Xevel/ssslidar/README.md

# ssslidar
Small Solid State Lidar

The SSSlidar is a (W) 29 x (L) 39 x (H) 21 mm sensor. It is composed of 13 TOF distance sensors, 12 arranged in circular pattern and 1 looking perpendicular to the others.
