Xevel/ssslidar/elec/ssslidar_v1.0_blade_SIG_bottom.brd

## EAGLE design elec/ssslidar_v1.0_blade_SIG_bottom.brd (2016-09-15)

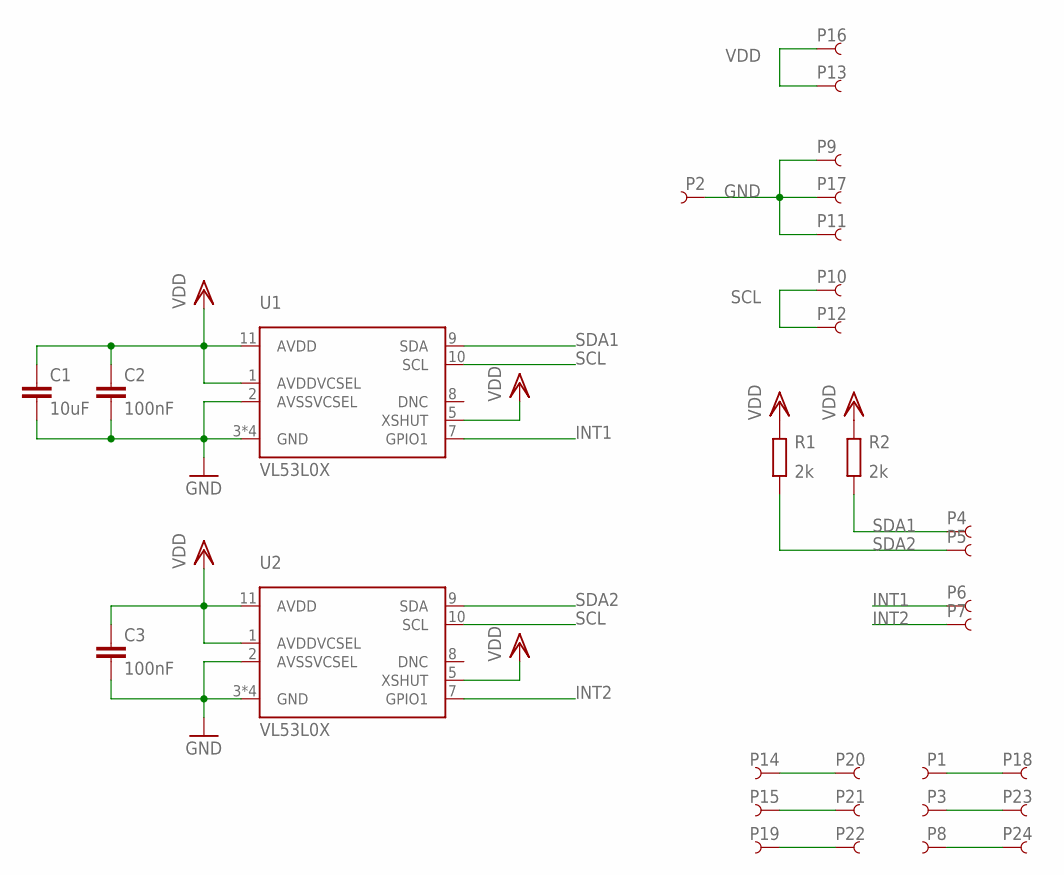
[picture p1: schematic ssslidar_v1.0_blade_SIG_bottom.sch]

Parts:
C1: 10uF; 0805_N
C2, C3: 100nF; 0402_N
P1, P3, P4, P5, P6, P7, P8, P14, P15, P18, P19, P20, P21, P22, P23, P24: PIN_SMD_0.8X1_RECT
P2, P9, P10, P11, P12, P13, P16, P17: PIN_SMD_1X2
R1, R2: 2k; 0402_N
U1, U2: VL53L0X

Connections:
GND: C1.2, C2.2, C3.2, P2.P$1, P9.P$1, P11.P$1, P17.P$1, U1.2 (AVSSVCSEL), U1.3 (GND), U1.4 (GND), U1.6 (GND), U1.12 (GND), U2.2 (AVSSVCSEL), U2.3 (GND), U2.4 (GND), U2.6 (GND), U2.12 (GND)
INT1: P6.PIN, U1.7 (GPIO1)
INT2: P7.PIN, U2.7 (GPIO1)
unnamed: P14.PIN, P20.PIN
unnamed: P15.PIN, P21.PIN
unnamed: P19.PIN, P22.PIN
unnamed: P1.PIN, P18.PIN
unnamed: P3.PIN, P23.PIN
unnamed: P8.PIN, P24.PIN
SCL: P10.P$1, P12.P$1, U1.10 (SCL), U2.10 (SCL)
SDA1: P4.PIN, R2.1, U1.9 (SDA)
SDA2: P5.PIN, R1.1, U2.9 (SDA)
VDD: C1.1, C2.1, C3.1, P13.P$1, P16.P$1, R1.2, R2.2, U1.1 (AVDDVCSEL), U1.5 (XSHUT), U1.11 (AVDD), U2.1 (AVDDVCSEL), U2.5 (XSHUT), U2.11 (AVDD)

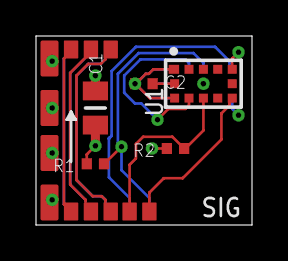
[picture p2: board ssslidar_v1.0_blade_SIG_bottom.brd from above]

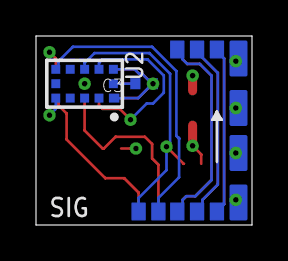
[picture p3: board ssslidar_v1.0_blade_SIG_bottom.brd from below]

Board: 4 copper layers, 12.0 x 10.5 mm, 31 parts (14 on the bottom side), 13 nets.
