Xevel/ssslidar/elec/ssslidar_v1.0_middle_plate.brd

## EAGLE design elec/ssslidar_v1.0_middle_plate.brd (2016-09-15)

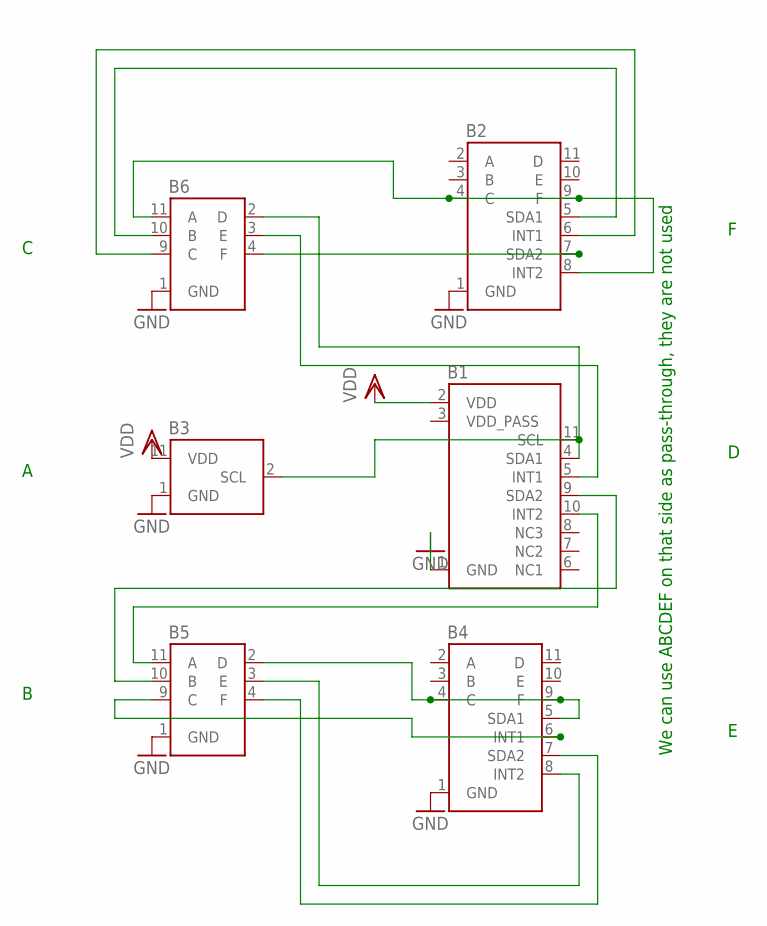
[picture p4: schematic ssslidar_v1.0_middle_plate.sch]

Parts:
B1: BLADE_PWR_BOTTOM; BLADE
B2, B4: BLADE_SIG_BOTTOM; BLADE
B3: BLADE_PWR_TOP; BLADE
B5, B6: BLADE_SIG_TOP; BLADE

Connections:
GND: B1.1 (GND), B2.1 (GND), B3.1 (GND), B4.1 (GND), B5.1 (GND), B6.1 (GND)
unnamed: B1.11 (SCL), B3.2 (SCL)
unnamed: B2.4 (C), B2.8 (INT2), B2.9 (F), B6.11 (A)
unnamed: B2.5 (SDA1), B6.10 (B)
unnamed: B2.6 (INT1), B6.9 (C)
unnamed: B1.5 (INT1), B6.3 (E)
unnamed: B2.7 (SDA2), B6.4 (F)
unnamed: B4.8 (INT2), B5.3 (E)
unnamed: B4.4 (C), B4.5 (SDA1), B4.9 (F), B5.2 (D)
unnamed: B4.6 (INT1), B5.9 (C)
unnamed: B1.9 (SDA2), B5.10 (B)
unnamed: B1.10 (INT2), B5.11 (A)
unnamed: B1.4 (SDA1), B6.2 (D)
unnamed: B4.7 (SDA2), B5.4 (F)
VDD: B1.2 (VDD), B3.11 (VDD)

Notes on the sheet:
We can use ABCDEF on that side as pass-through, they are not used

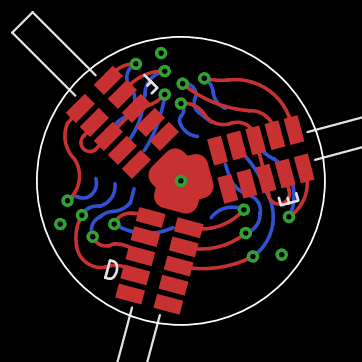
[picture p5: board ssslidar_v1.0_middle_plate.brd from above]

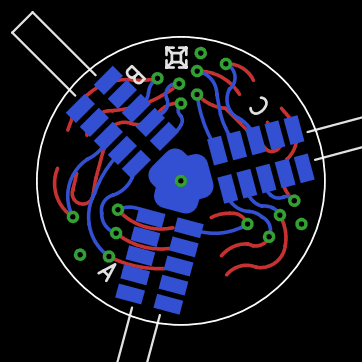
[picture p6: board ssslidar_v1.0_middle_plate.brd from below]

Board: 4 copper layers, 16.0 x 16.0 mm, 7 parts (4 on the bottom side), 15 nets.

Other parts of the board:
U$1: XEVELABS_LOGO_S
