Xevel/ssslidar/elec/ssslidar_v1.0_main_board.brd

## EAGLE design elec/ssslidar_v1.0_main_board.brd (2016-09-15)

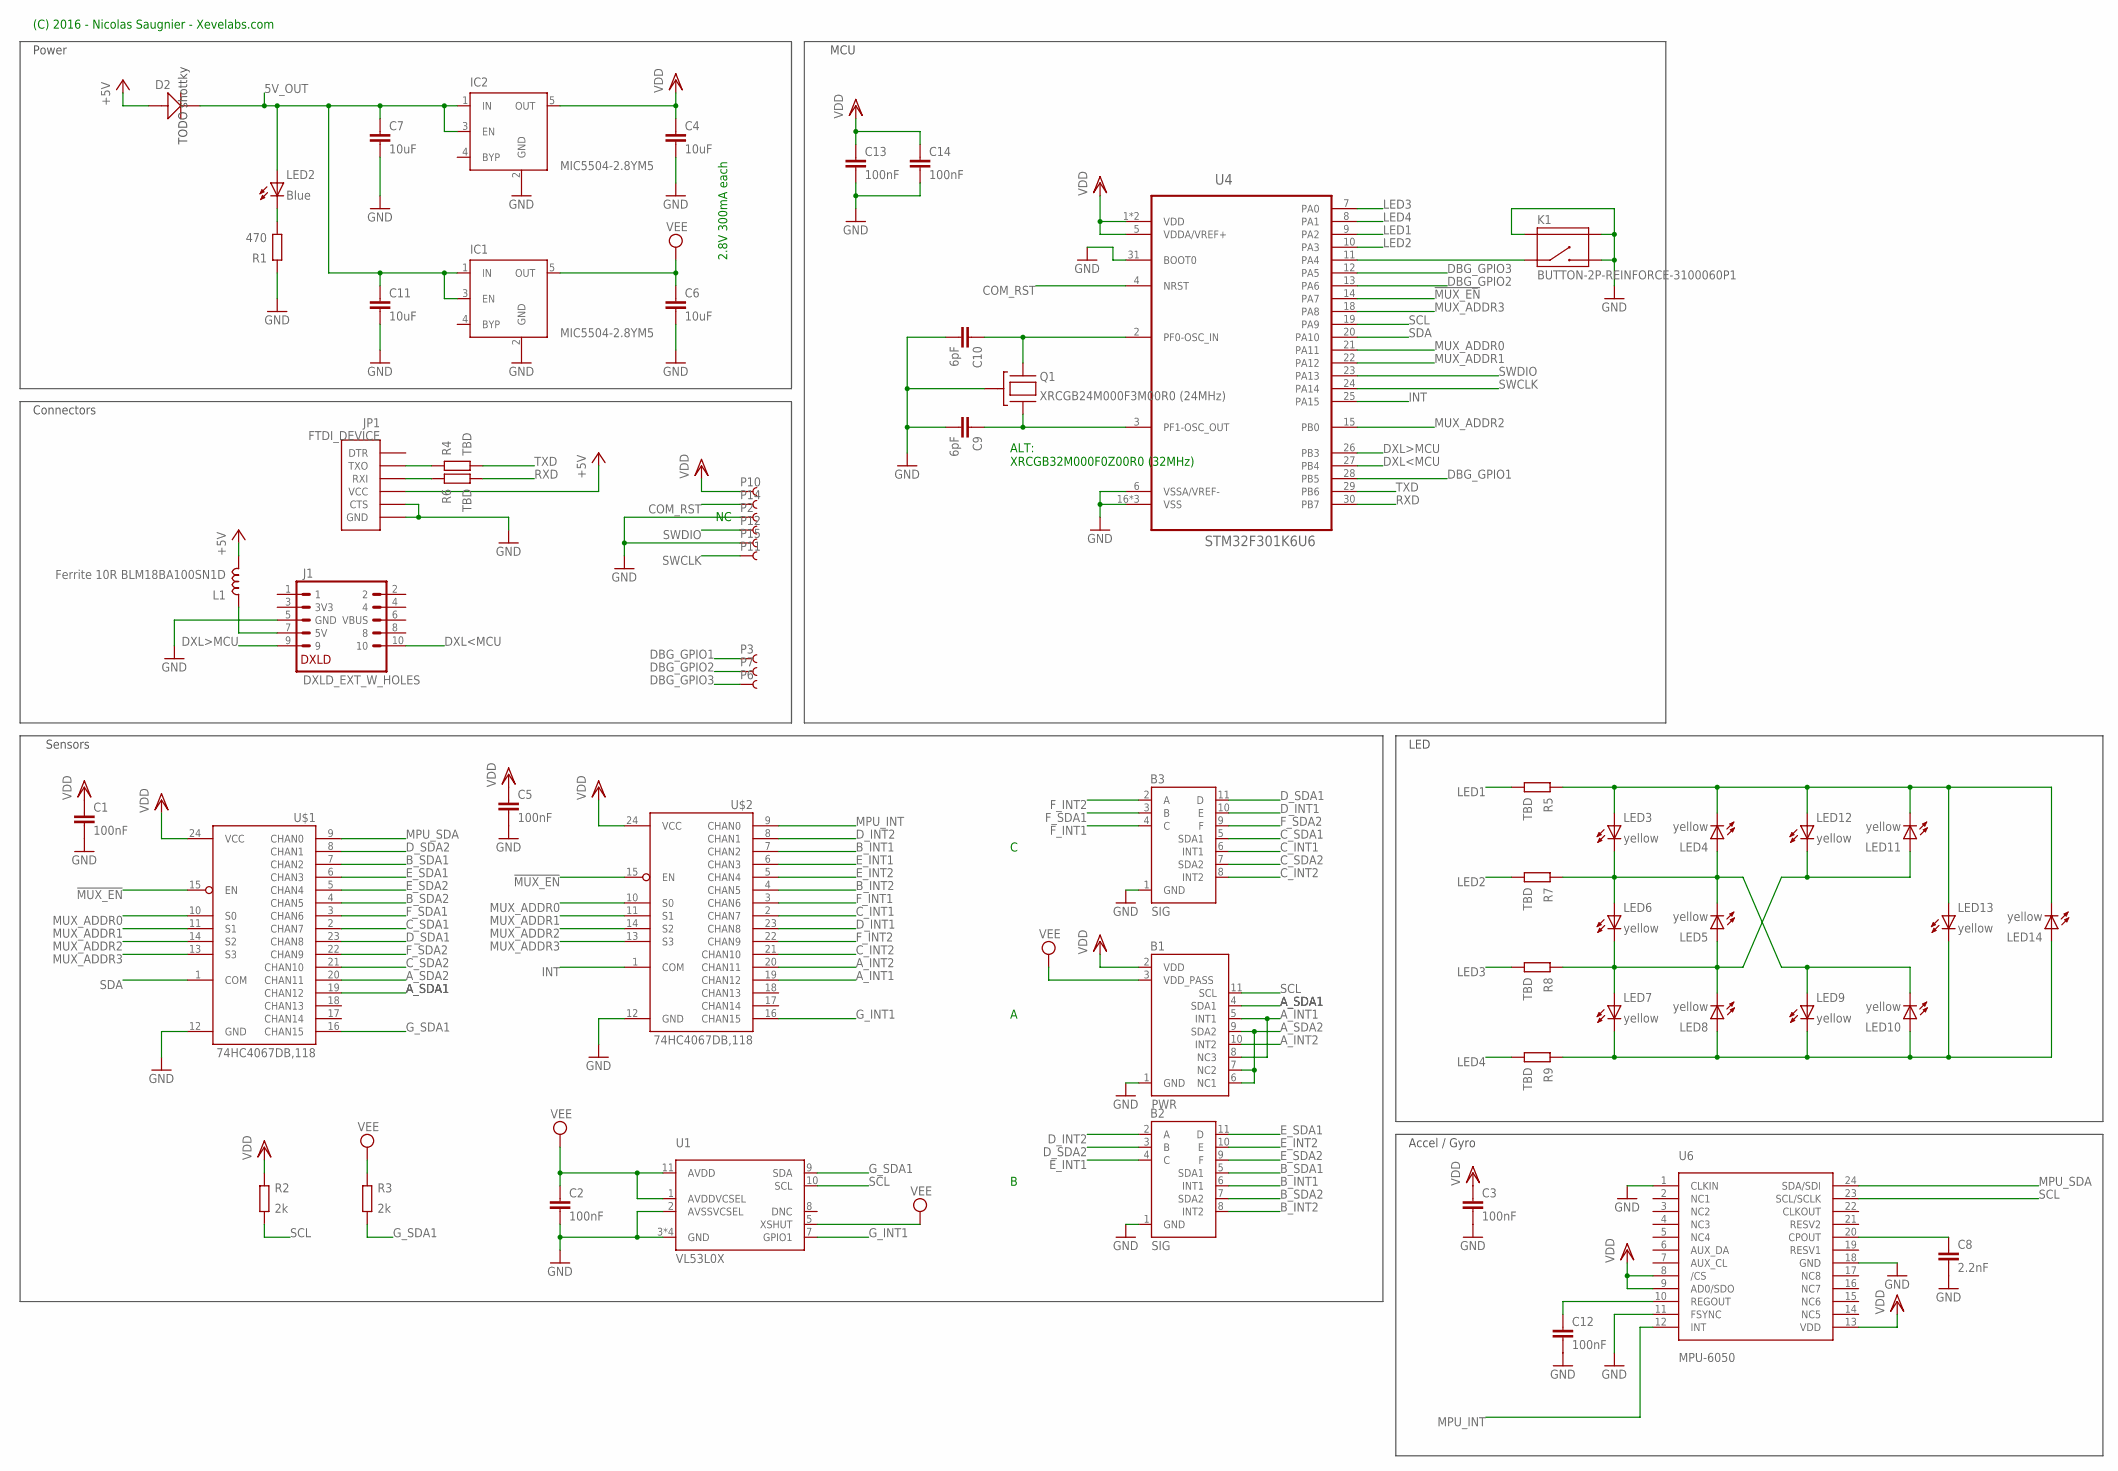
[picture p7: schematic ssslidar_v1.0_main_board.sch]

Parts:
B1: PWR; BLADE
B2, B3: SIG; BLADE
C1, C2, C3, C5, C12, C13, C14: 100nF; 0402_N
C4, C6, C7, C11: 10uF; 0805_N
C8: 2.2nF; 0402_N
C9, C10: 6pF; 0402_N
D2: D-SOD-123; SOD123
IC1, IC2: MIC5504-2.8YM5; SOT23-5
J1: DXLD_EXT_W_HOLES
JP1: FTDI_DEVICE; FTDI_DEVICE_SIDE
K1: BUTTON-2P-REINFORCE-3100060P1; 4P-SMD-7.0X3.5X3.5H-90D
L1: Ferrite 10R BLM18BA100SN1D; 0603_N
LED2: Blue; D_0603_N
LED3, LED4, LED5, LED6, LED7, LED8, LED9, LED10, LED11, LED12, LED13, LED14: yellow; D_0603_N
P2, P10, P11, P12, P14, P15: PIN_SMD_1X1.6
P3, P6, P7: PIN_SMD_1X1
Q1: XRCGB24M000F3M00R0 (24MHz); CRYSTAL_2.0X1.6_4P
R1: 470; 0402_N
R2, R3: 2k; 0402_N
R4, R5, R6, R7, R8, R9: TBD; 0402_N
U1: VL53L0X
U4: STM32F301K6U6; QFN50P500X500X60-33N
U6: MPU-6050; QFN-24
U$1, U$2: 74HC4067DB,118; SSOP24

Connections:
5V_OUT: C7.1, C11.1, D2.-, IC1.1 (IN), IC1.3 (EN), IC2.1 (IN), IC2.3 (EN), LED2.A
!MUX_EN: U4.14 (PA7), U$1.15 (EN), U$2.15 (EN)
+5V: D2.+, JP1.P$4 (VCC), L1.2
A_INT1: B1.5 (INT1), B1.8 (NC3), U$2.19 (CHAN12)
A_INT2: B1.10 (INT2), U$2.20 (CHAN11)
A_SDA1: B1.4 (SDA1), U$1.19 (CHAN12)
A_SDA2: B1.6 (NC1), B1.7 (NC2), B1.9 (SDA2), U$1.20 (CHAN11)
B_INT1: B2.6 (INT1), U$2.7 (CHAN2)
B_INT2: B2.8 (INT2), U$2.4 (CHAN5)
B_SDA1: B2.5 (SDA1), U$1.7 (CHAN2)
B_SDA2: B2.7 (SDA2), U$1.4 (CHAN5)
COM_RST: P14.PIN, U4.4 (NRST)
C_INT1: B3.6 (INT1), U$2.2 (CHAN7)
C_INT2: B3.8 (INT2), U$2.21 (CHAN10)
C_SDA1: B3.5 (SDA1), U$1.2 (CHAN7)
C_SDA2: B3.7 (SDA2), U$1.21 (CHAN10)
DBG_GPIO1: P3.P$1, U4.28 (PB5)
DBG_GPIO2: P7.P$1, U4.13 (PA6)
DBG_GPIO3: P6.P$1, U4.12 (PA5)
DXL<MCU: J1.10, U4.27 (PB4)
DXL>MCU: J1.9, U4.26 (PB3)
D_INT1: B3.10 (E), U$2.23 (CHAN8)
D_INT2: B2.2 (A), U$2.8 (CHAN1)
D_SDA1: B3.11 (D), U$1.23 (CHAN8)
D_SDA2: B2.3 (B), U$1.8 (CHAN1)
E_INT1: B2.4 (C), U$2.6 (CHAN3)
E_INT2: B2.10 (E), U$2.5 (CHAN4)
E_SDA1: B2.11 (D), U$1.6 (CHAN3)
E_SDA2: B2.9 (F), U$1.5 (CHAN4)
F_INT1: B3.4 (C), U$2.3 (CHAN6)
F_INT2: B3.2 (A), U$2.22 (CHAN9)
F_SDA1: B3.3 (B), U$1.3 (CHAN6)
F_SDA2: B3.9 (F), U$1.22 (CHAN9)
GND: B1.1 (GND), B2.1 (GND), B3.1 (GND), C1.2, C2.2, C3.2, C4.2, C5.2, C6.2, C7.2, C8.2, C9.2, C10.2, C11.2, C12.2, C13.2, C14.2, IC1.2 (GND), IC2.2 (GND), J1.5 (GND), JP1.P$5 (CTS), JP1.P$6 (GND), K1.2, K1.S1, K1.S2, P2.PIN, P15.PIN, Q1.2 (GND), Q1.4 (GND), R1.2, U1.2 (AVSSVCSEL), U1.3 (GND), U1.4 (GND), U1.6 (GND), U1.12 (GND), U4.6 (VSSA/VREF-), U4.16 (VSS), U4.31 (BOOT0), U4.32 (VSS), U4.33 (VSS), U6.1 (CLKIN), U6.11 (FSYNC), U6.18 (GND), U$1.12 (GND), U$2.12 (GND)
G_INT1: U1.7 (GPIO1), U$2.16 (CHAN15)
G_SDA1: R3.1, U1.9 (SDA), U$1.16 (CHAN15)
INT: U4.25 (PA15), U$2.1 (COM)
LED1: R5.1, U4.9 (PA2)
LED2: R7.1, U4.10 (PA3)
LED3: R8.1, U4.7 (PA0)
LED4: R9.1, U4.8 (PA1)
MPU_INT: U6.12 (INT), U$2.9 (CHAN0)
MPU_SDA: U6.24 (SDA/SDI), U$1.9 (CHAN0)
MUX_ADDR0: U4.21 (PA11), U$1.10 (S0), U$2.10 (S0)
MUX_ADDR1: U4.22 (PA12), U$1.11 (S1), U$2.11 (S1)
MUX_ADDR2: U4.15 (PB0), U$1.14 (S2), U$2.14 (S2)
MUX_ADDR3: U4.18 (PA8), U$1.13 (S3), U$2.13 (S3)
unnamed: C10.1, Q1.1, U4.2 (PF0-OSC_IN)
unnamed: C9.1, Q1.3, U4.3 (PF1-OSC_OUT)
unnamed: K1.1, U4.11 (PA4)
unnamed: J1.7 (5V), L1.1
unnamed: LED2.C, R1.1
unnamed: LED3.A, LED4.C, LED11.C, LED12.A, LED13.A, LED14.C, R5.2
unnamed: LED3.C, LED4.A, LED5.C, LED6.A, LED9.A, LED10.C, R7.2
unnamed: LED5.A, LED6.C, LED7.A, LED8.C, LED11.A, LED12.C, R8.2
unnamed: LED7.C, LED8.A, LED9.C, LED10.A, LED13.C, LED14.A, R9.2
unnamed: JP1.P$2 (TXO), R4.2
unnamed: JP1.P$3 (RXI), R6.2
unnamed: C12.1, U6.10 (REGOUT)
unnamed: C8.1, U6.20 (CPOUT)
RXD: R6.1, U4.30 (PB7)
SCL: B1.11 (SCL), R2.1, U1.10 (SCL), U4.19 (PA9), U6.23 (SCL/SCLK)
SDA: U4.20 (PA10), U$1.1 (COM)
SWCLK: P11.PIN, U4.24 (PA14)
SWDIO: P12.PIN, U4.23 (PA13)
TXD: R4.1, U4.29 (PB6)
VDD: B1.2 (VDD), C1.1, C3.1, C4.1, C5.1, C13.1, C14.1, IC2.5 (OUT), P10.PIN, R2.2, U4.1 (VDD), U4.5 (VDDA/VREF+), U4.17 (VDD), U6.8 (/CS), U6.9 (AD0/SDO), U6.13 (VDD), U$1.24 (VCC), U$2.24 (VCC)
VEE: B1.3 (VDD_PASS), C2.1, C6.1, IC1.5 (OUT), R3.2, U1.1 (AVDDVCSEL), U1.5 (XSHUT), U1.11 (AVDD)

Notes on the sheet:
2.8V 300mA each
Connectors
LED
Power
ALT: XRCGB32M000F0Z00R0 (32MHz)
MCU
(C) 2016 - Nicolas Saugnier - Xevelabs.com
Sensors
TODO shottky
Accel / Gyro

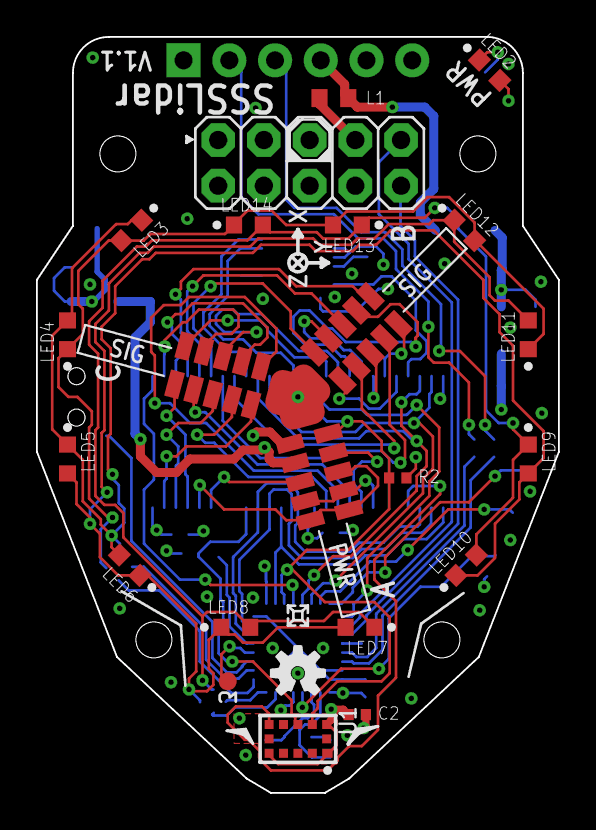
[picture p8: board ssslidar_v1.0_main_board.brd from above]

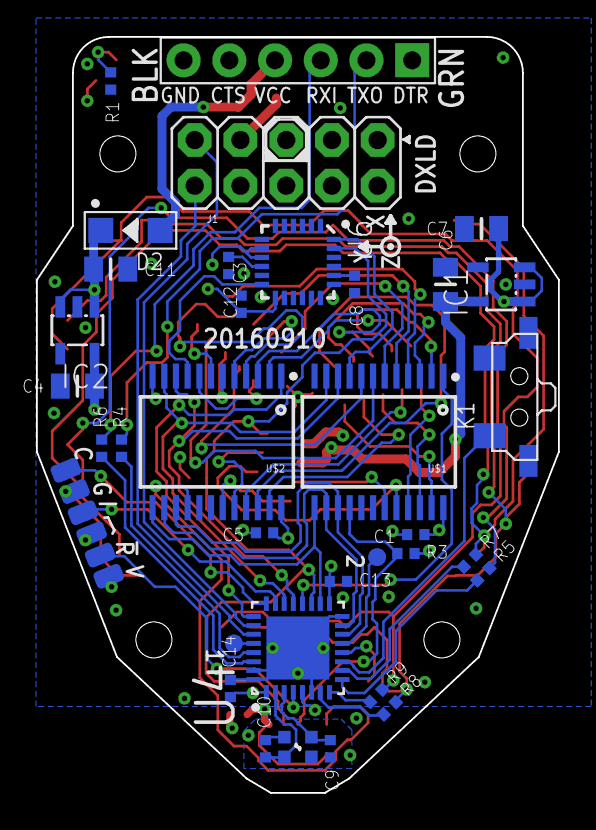
[picture p9: board ssslidar_v1.0_main_board.brd from below]

Board: 4 copper layers, 29.0 x 42.0 mm, 63 parts (40 on the bottom side), 68 nets.

Other parts of the board:
U$3: XEVELABS_LOGO_S
U$4: OSHW-LOGO-S
