Xevel/ssslidar/elec/ssslidar.ioc

Mcu.UserName=STM32F301K6Ux
PA0.Signal=S_TIM2_CH1_ETR
PA1.Signal=S_TIM2_CH2
PA10.Signal=I2C2_SDA
PA13.Signal=SYS_JTMS-SWDIO
PA14.Signal=SYS_JTCK-SWCLK
PA2.Signal=S_TIM2_CH3
PA3.Signal=S_TIM2_CH4
PA9.Signal=I2C2_SCL
PB3.Signal=USART2_TX
PB4.Signal=USART2_RX
PB6.Signal=USART1_TX
PB7.Signal=USART1_RX
PF0-OSC_IN.Signal=RCC_OSC_IN
PF1-OSC_OUT.Signal=RCC_OSC_OUT
