Xevel/ssslidar/(commit log)

2016-08-12 Added VL53L0X lib Added PWR blade
    [ssslidar_v0.1_blade_PWR.brd, ssslidar_v0.1_blade_PWR.sch]
2016-08-12 Added SIG blade.
    [ssslidar_v0.1_blade_SIG.brd, ssslidar_v0.1_blade_SIG.sch]
2016-08-13 Added middle plate
    [ssslidar_v0.1_middle_plate.brd, ssslidar_v0.1_middle_plate.sch]
2016-08-13 Cosmetic improvements on middle plate
    [ssslidar_v0.1_middle_plate.brd]
2016-08-13 Added main board (wip)
    [ssslidar_v0.1_main_board.brd, ssslidar_v0.1_main_board.sch]
2016-08-14 Working on main board Made blades longer to avoid too much occlusion from the main PCB (but we will still need to put the whole thing on a mast).
    [ssslidar_v0.1_blade_PWR.brd, ssslidar_v0.1_blade_PWR.sch, ssslidar_v0.1_blade_SIG.brd, ssslidar_v0.1_blade_SIG.sch, ssslidar_v0.1_main_board.brd, ssslidar_v0.1_main_board.sch]
2016-09-06 Updated blades (ready for release). Double power rail for sensors.
    [ssslidar_v0.1_blade_PWR.brd, ssslidar_v0.1_blade_PWR.sch, ssslidar_v0.1_blade_SIG.brd, ssslidar_v0.1_blade_SIG.sch, ssslidar_v0.1_main_board.brd, ssslidar_v0.1_main_board.sch, ssslidar_v0.1_middle_plate.brd]
2016-09-06 Added stm32f301 configuration
2016-09-06 Fixed middle plate with double power rails
    [ssslidar_v0.1_middle_plate.brd, ssslidar_v0.1_middle_plate.sch]
2016-09-06 Main board outline and schematics nearly ready
    [ssslidar_v0.1_main_board.brd, ssslidar_v0.1_main_board.sch]
2016-09-06 Added leds, finished sch
    [ssslidar_v0.1_main_board.brd, ssslidar_v0.1_main_board.sch]
2016-09-06 Routing WIP
    [ssslidar_v0.1_main_board.brd, ssslidar_v0.1_main_board.sch]
2016-09-07 Made blades slightly taller (7mm instead of 6.5)
    [ssslidar_v0.1_blade_PWR.brd, ssslidar_v0.1_blade_SIG.brd]
2016-09-07 Routed blades
    [ssslidar_v0.1_main_board.brd, ssslidar_v0.1_main_board.sch]
2016-09-07 LEDs routed. Mostly power left to route.
    [ssslidar_v0.1_main_board.brd, ssslidar_v0.1_main_board.sch]
2016-09-08 Only power and cosmetics left
    [ssslidar_v0.1_main_board.brd, ssslidar_v0.1_main_board.sch]
2016-09-08 Routing done.
    [ssslidar_v0.1_blade_PWR.brd, ssslidar_v0.1_blade_SIG.brd, ssslidar_v0.1_main_board.brd, ssslidar_v0.1_main_board.sch]
2016-09-10 Added MPU-6050 and changed the extension footprint to match the DXLD Interface. Some connections still needed.
    [ssslidar_v1.0_main_board.brd, ssslidar_v1.0_main_board.sch]
2016-09-11 Finalized V1.0.
    [ssslidar_v1.0_main_board.brd, ssslidar_v1.0_main_board.sch]
2016-09-11 Upadted blade footprint, put everything in v1.0
    [ssslidar_v0.1_main_board.brd, ssslidar_v0.1_main_board.sch, ssslidar_v1.0_blade_PWR_top.brd, ssslidar_v1.0_blade_PWR_top.sch, ssslidar_v1.0_blade_SIG_top.brd, ssslidar_v1.0_blade_SIG_top.sch, ssslidar_v1.0_main_board.brd, ssslidar_v1.0_main_board.sch]
2016-09-11 Separated blades into bottom and top, since the bottom ones need to be taller to avoid seeing the Main PCB, or the screws...
    [ssslidar_v1.0_blade_PWR_bottom.brd, ssslidar_v1.0_blade_PWR_bottom.sch, ssslidar_v1.0_blade_PWR_top.brd, ssslidar_v1.0_blade_PWR_top.sch, ssslidar_v1.0_blade_SIG_bottom.brd, ssslidar_v1.0_blade_SIG_bottom.sch]
2016-09-11 Blades redesign done.
    [ssslidar_v1.0_blade_PWR_bottom.brd, ssslidar_v1.0_blade_PWR_bottom.sch, ssslidar_v1.0_blade_SIG_bottom.brd]
2016-09-15 Aesthetic modifs
    [ssslidar_v1.0_main_board.brd, ssslidar_v1.0_main_board.sch]
2016-09-15 Updated all libs.
    [ssslidar_v1.0_blade_PWR_bottom.brd, ssslidar_v1.0_blade_PWR_bottom.sch, ssslidar_v1.0_blade_PWR_top.brd, ssslidar_v1.0_blade_PWR_top.sch, ssslidar_v1.0_blade_SIG_bottom.brd, ssslidar_v1.0_blade_SIG_bottom.sch, ssslidar_v1.0_blade_SIG_top.brd, ssslidar_v1.0_blade_SIG_top.sch]
